219-design/me218/README.md

# me218
Repo for Smart Product Design Lab Alumni content!
