219-design/me218/pcb-ruler/mechanical/README.md

# ME218 PCB Ruler Mechanical Resources

Explore our demo designs in [Onshape](https://cad.onshape.com/documents/a66641dbc2e63d92f0bfc751/w/f00ac217e622a64d2a372b85/e/9fa5ab666376091f7bf63026). 

Mechanical Demos

This folder is for 3D printable resources and assembly instructions for add-ons to the PCB ruler.

Looking for a design related to an interdisciplinary project? Check out the [examples folder](https://github.com/219-design/me218/tree/lib/pcb-ruler/firmware/ruler_lib/examples).

---

The PCB ruler is also a great platform for **3D-printed attachments**.  

We’ve designed a **3D-printable clamp** that securely grips the ruler and can be adapted for a variety of uses — such as **tool holders**, **marking tools**, or other creative mechanical add-ons.  

## Demo Photos
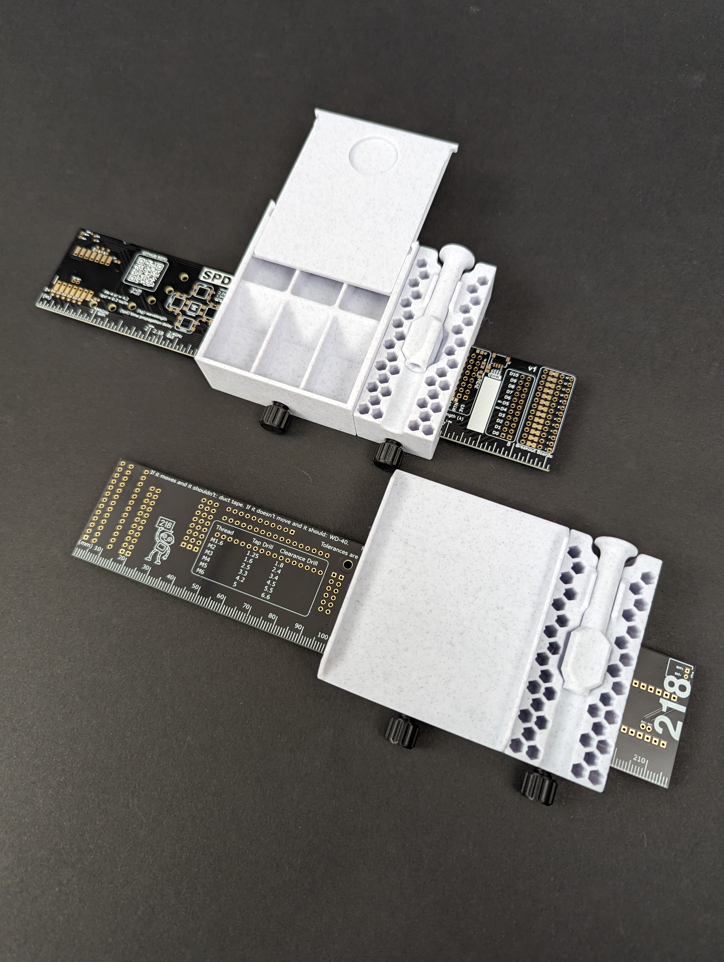
[picture p5: pcb-ruler/mechanical/photos/PXL_20251010_201851201.jpg]
Storage

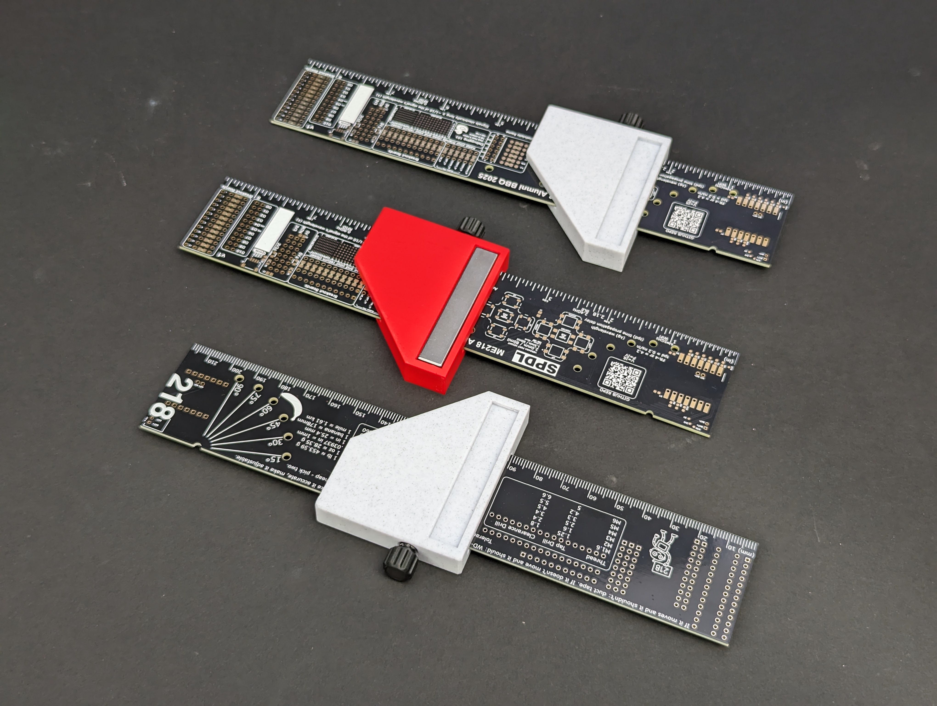
[picture p6: pcb-ruler/mechanical/photos/PXL_20251009_214241313.jpg]
Marking Tool


## CAD Photos
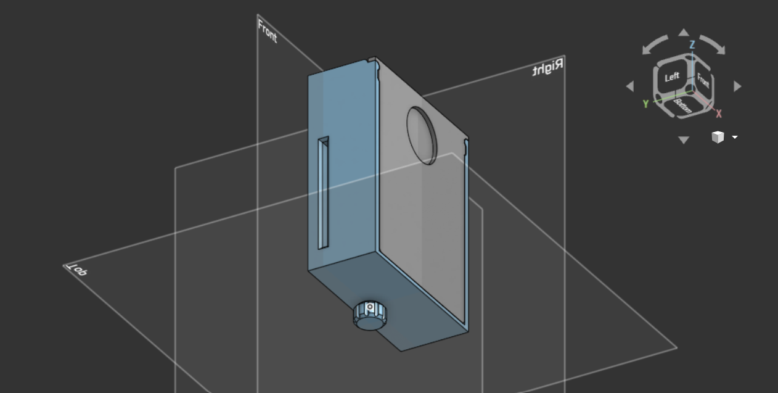
[picture p7: pcb-ruler/mechanical/photos/Screenshot 2025-10-10 151649.png]
CAD Photo 1

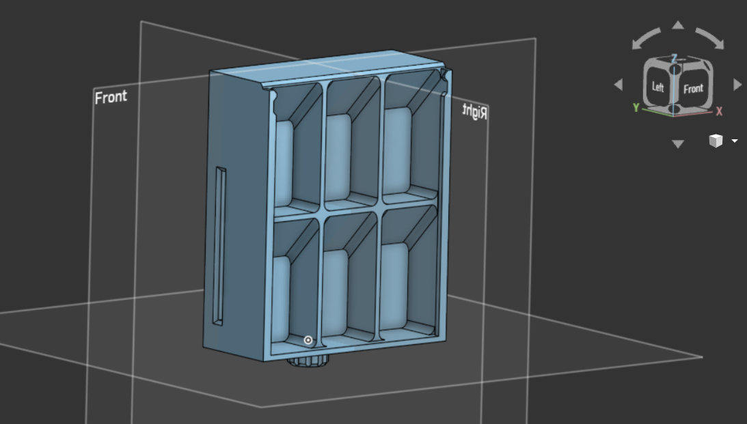
[picture p8: pcb-ruler/mechanical/photos/Screenshot 2025-10-10 151750.png]
CAD Photo 2

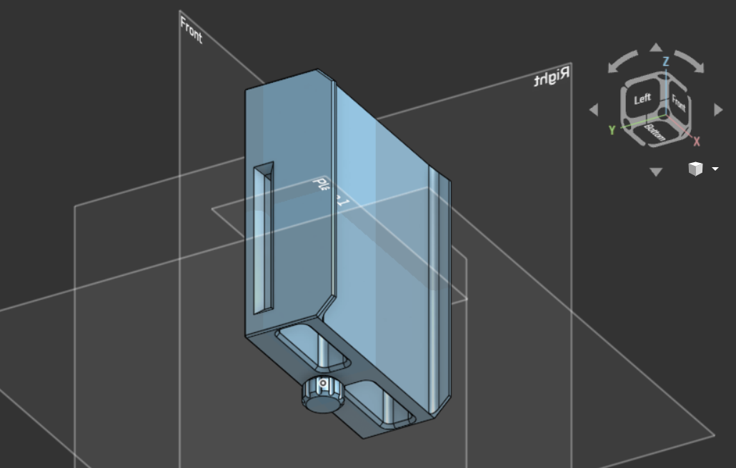
[picture p9: pcb-ruler/mechanical/photos/Screenshot 2025-10-10 151845.png]
CAD Photo 3

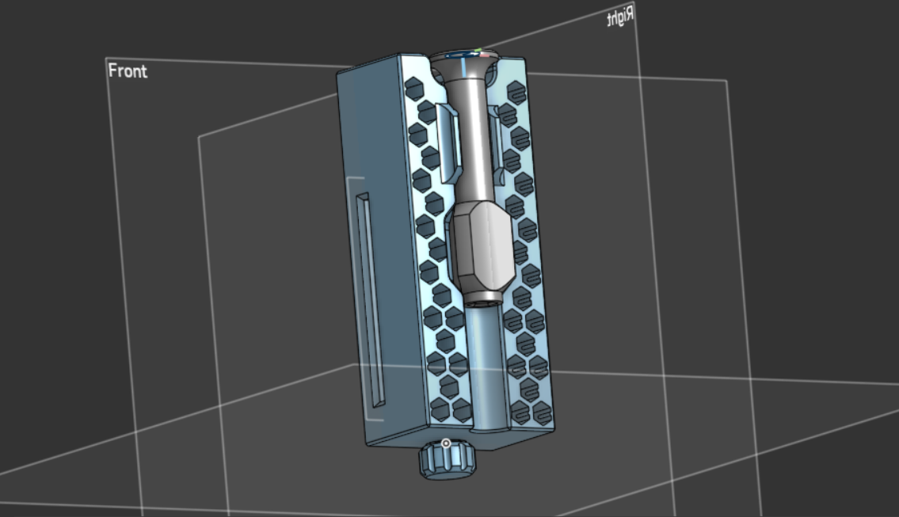
[picture p10: pcb-ruler/mechanical/photos/Screenshot 2025-10-10 152130.png]
CAD Photo 4

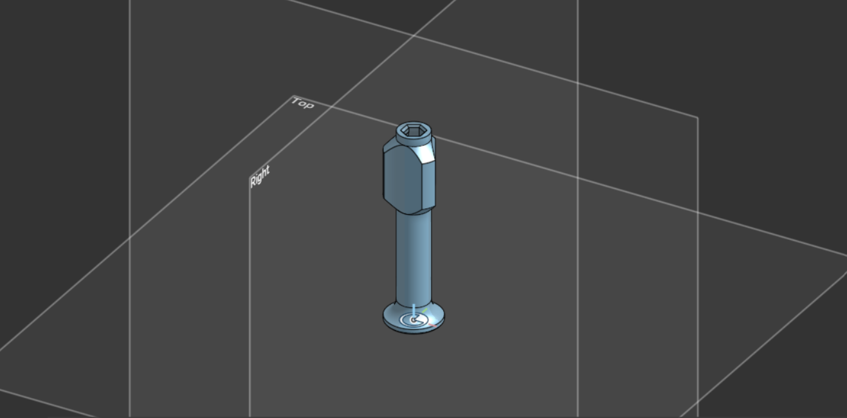
[picture p11: pcb-ruler/mechanical/photos/Screenshot 2025-10-10 152235.png]
CAD Photo 5

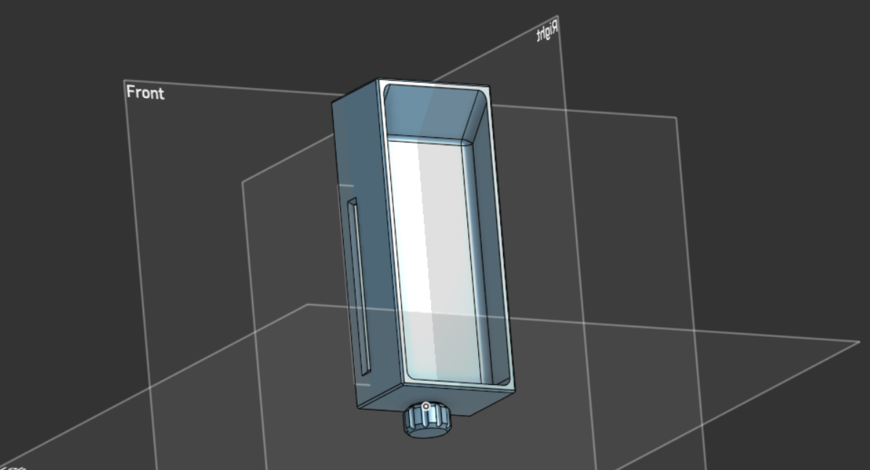
[picture p12: pcb-ruler/mechanical/photos/Screenshot 2025-10-10 152332.png]
CAD Photo 6
