219-design/me218/pcb-ruler/firmware/README.md

# ME218 PCB Ruler Firmware Resources
This folder contains firmware examples for basic component functionality.

## Ruler Lib

The Ruler Lib is small collection of classes for using some of the hardware features of the ruler board. 

### Installing Ruler Lib

Open the Arduino IDE. 

Select: Sketch Menu >> Include Library >> Add .ZIP library...

In the file dialog, find the ruler_lib.zip file

This will install the ruler_lib to use with sketches

### Editing the Ruler Lib

If you'd like to make changes to the lib, you can modify the files in the src folder. Then compress the entire "ruler_lib" directory into a zip file and (re)install the new library from zip as described above.

### Included Examples

All examples in this repository are included in the Arduino IDE when the Ruler Lib is installed. To open an example from the IDE, such as the Simon Game example:

Select: File >> Examples >> ruler_lib >> simon_says

Any dependent libraries are noted with the github repository in the example code.

### Seed XIAO Boards 

Install Seed XIAO Boards the as instructed by:
https://wiki.seeedstudio.com/XIAO_BLE/#getting-started
