219-design/me218/pcb-ruler/firmware/ruler_lib/examples/tof_ruler/README.md

# ME218 PCB Ruler - ToF Ruler

This sketch creates line of sight digital ruler utilizing a time of flight sensor. Distances measured from the sensor will be displayed on the OLED screen. Pressing the button will change units from imperial to metric. Distances greater than 5400mm are outside of the sensors operating range and will not be accurate.

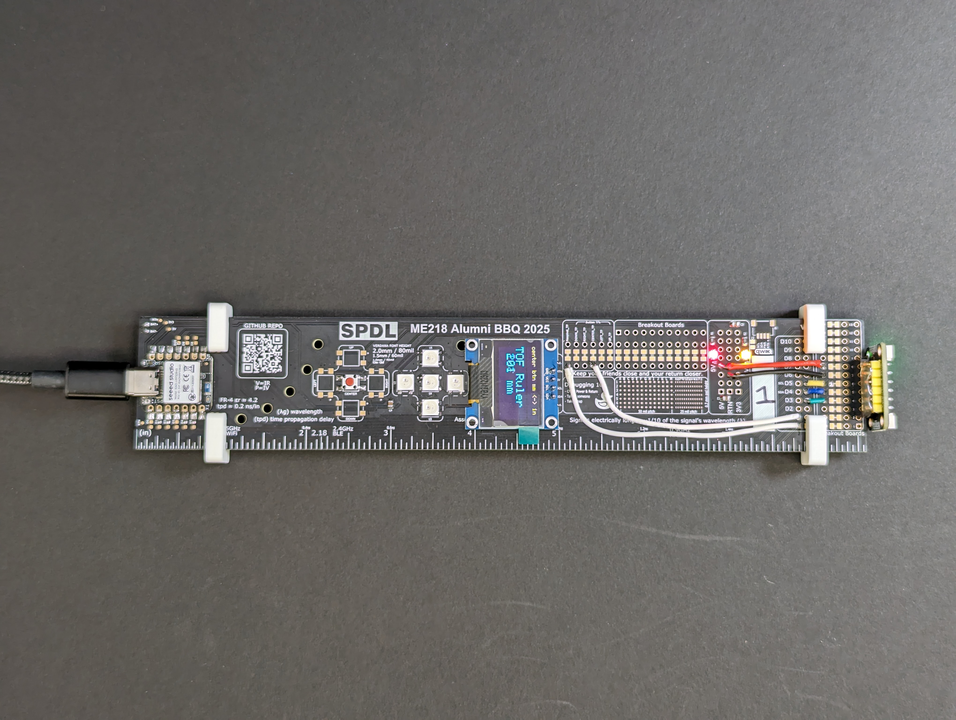
[picture p16: pcb-ruler/firmware/ruler_lib/examples/tof_ruler/photos/PXL_20251009_213353691.jpg]
tof
