219-design/me218/pcb-ruler/electrical/V1/ME218 Ruler v1 PCBA 3D (Bottom view).PDF

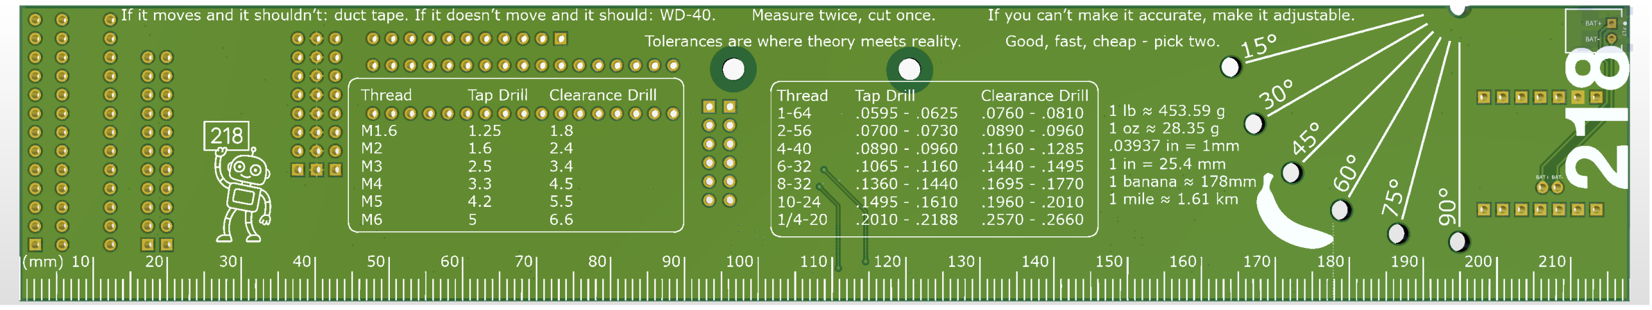
[picture p17: figure]
