219-design/me218/pcb-ruler/electrical/V1/ME218 Ruler v1 PCBA 3D (Top view).PDF

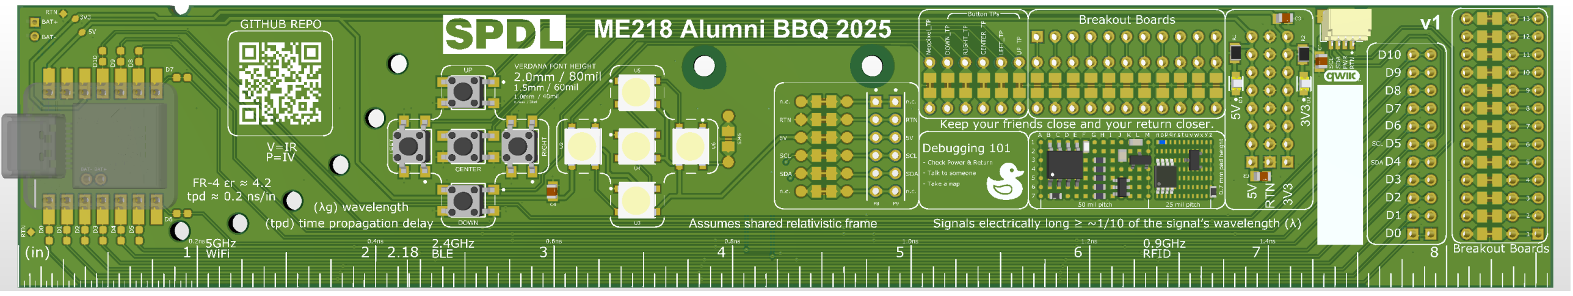
[picture p18: figure]
