219-design/me218/pcb-ruler/firmware/ruler_lib/examples/digital_level/ME218 RULER - - level.png

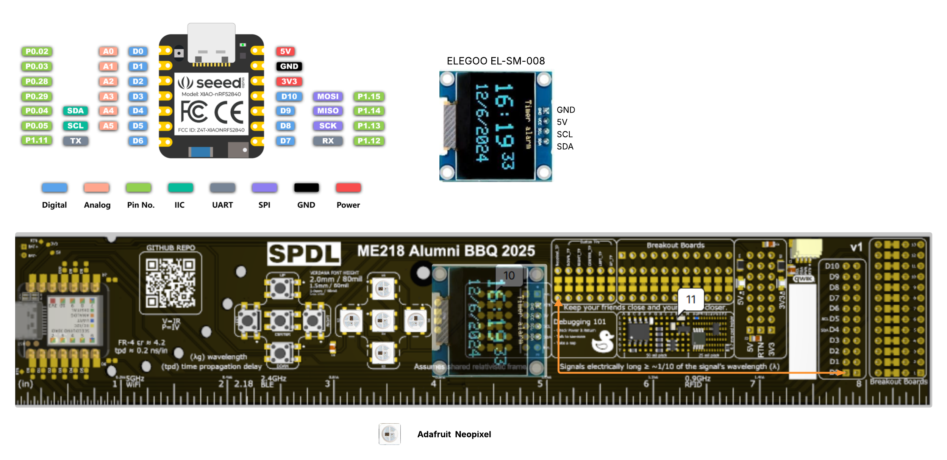
pcb-ruler/firmware/ruler_lib/examples/digital_level/ME218 RULER - - level.png
