219-design/me218/pcb-ruler/firmware/ruler_lib/examples/digital_level/photos/PXL_20251009_213537078.jpg

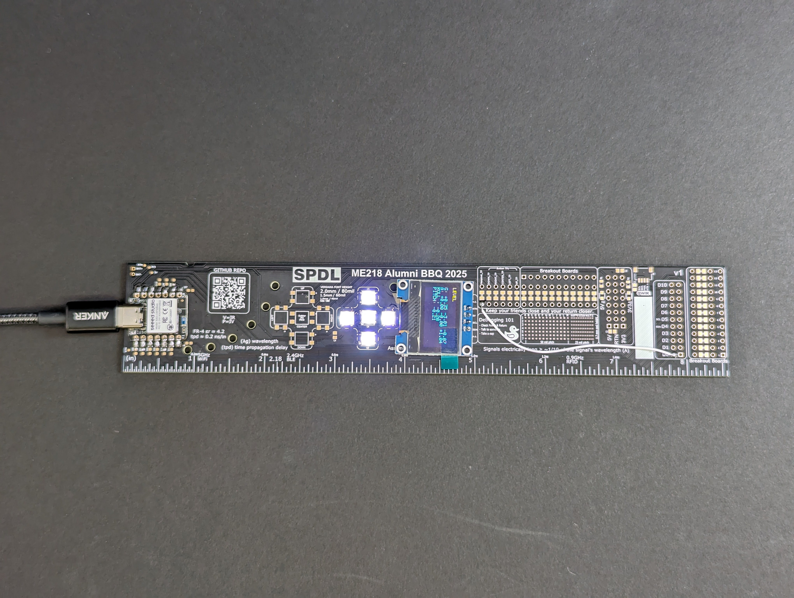
pcb-ruler/firmware/ruler_lib/examples/digital_level/photos/PXL_20251009_213537078.jpg
