219-design/me218/pcb-ruler/firmware/ruler_lib/examples/simon_says/ME218 RULER - - simon.png

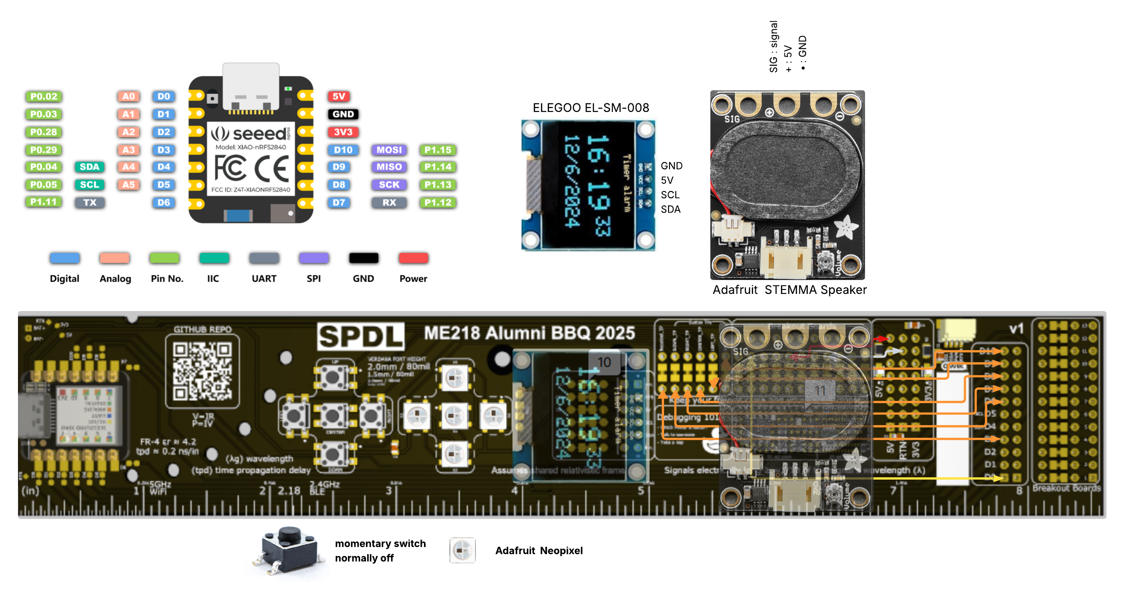
pcb-ruler/firmware/ruler_lib/examples/simon_says/ME218 RULER - - simon.png
