219-design/me218/pcb-ruler/firmware/ruler_lib/examples/simon_says/photos/PXL_20251009_213451061.jpg

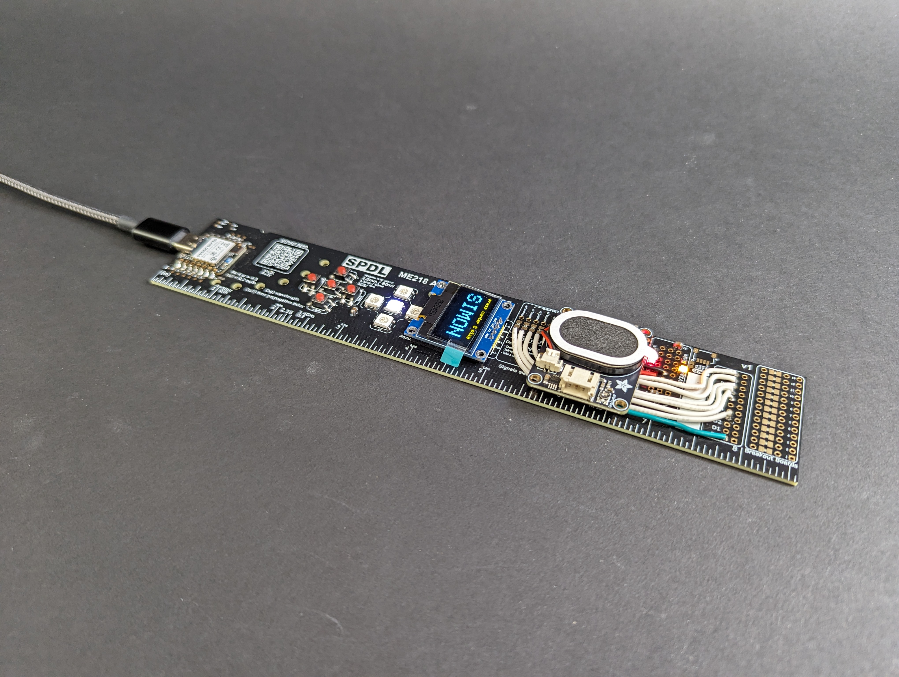
pcb-ruler/firmware/ruler_lib/examples/simon_says/photos/PXL_20251009_213451061.jpg
