219-design/me218/pcb-ruler/firmware/ruler_lib/examples/thermal_camera/ME218 RULER - - thermal cam.png

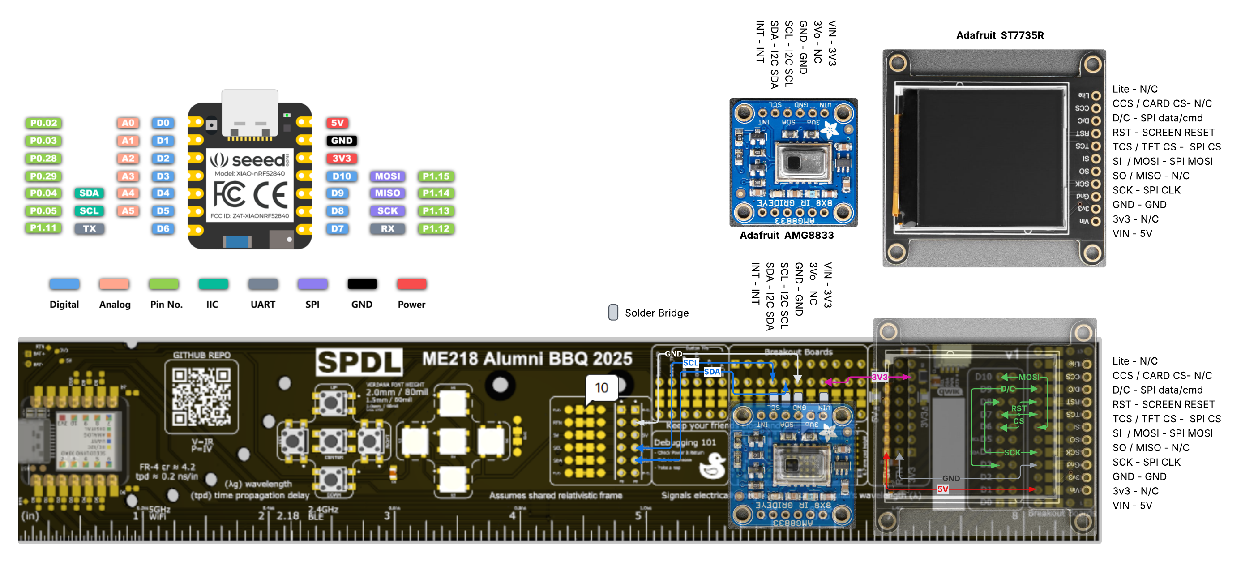
pcb-ruler/firmware/ruler_lib/examples/thermal_camera/ME218 RULER - - thermal cam.png
