219-design/me218/pcb-ruler/firmware/ruler_lib/examples/thermal_camera/photos/PXL_20251009_213652297.jpg

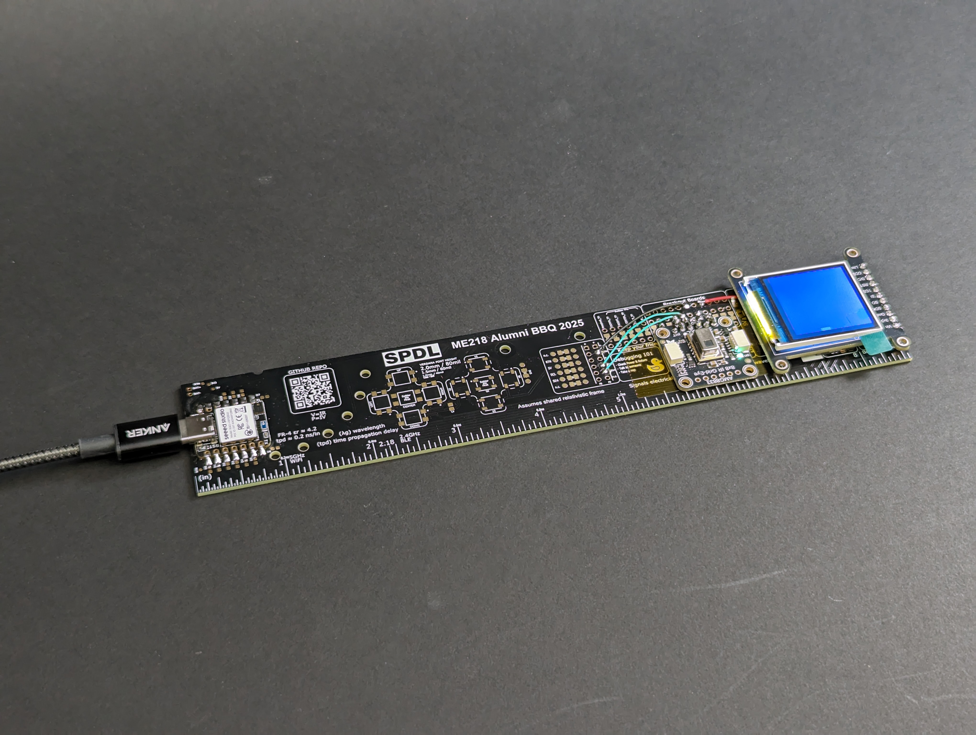
pcb-ruler/firmware/ruler_lib/examples/thermal_camera/photos/PXL_20251009_213652297.jpg
