219-design/me218/pcb-ruler/firmware/ruler_lib/examples/thermal_camera/photos/PXL_20251009_213659883.jpg

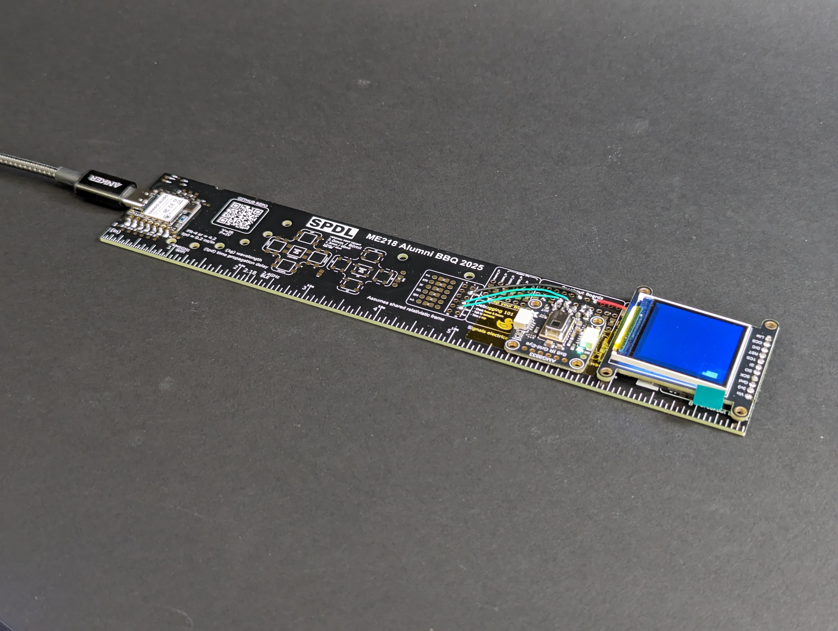
pcb-ruler/firmware/ruler_lib/examples/thermal_camera/photos/PXL_20251009_213659883.jpg
