219-design/me218/pcb-ruler/firmware/ruler_lib/examples/tof_ruler/ME218 RULER - - ToF.png

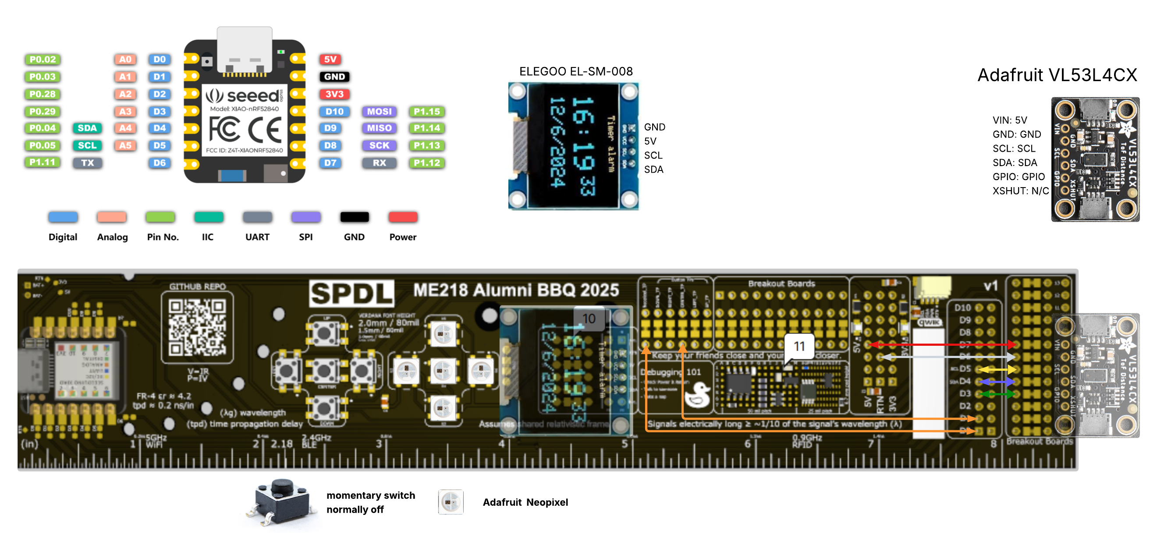
pcb-ruler/firmware/ruler_lib/examples/tof_ruler/ME218 RULER - - ToF.png
