219-design/me218/pcb-ruler/firmware/ruler_lib/examples/tof_ruler/photos/PXL_20251009_213426381.jpg

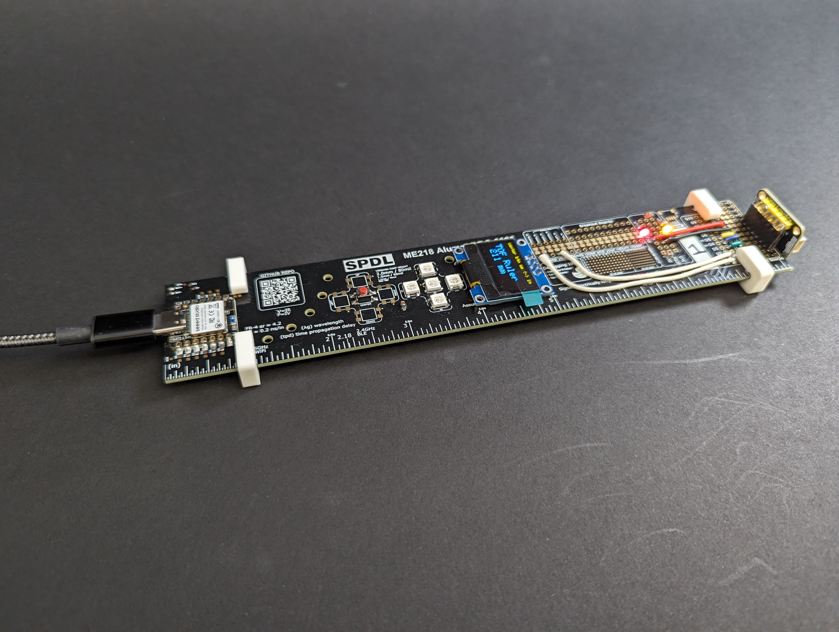
pcb-ruler/firmware/ruler_lib/examples/tof_ruler/photos/PXL_20251009_213426381.jpg
