219-design/me218/pcb-ruler/mechanical/photos/PXL_20251009_214215333.jpg

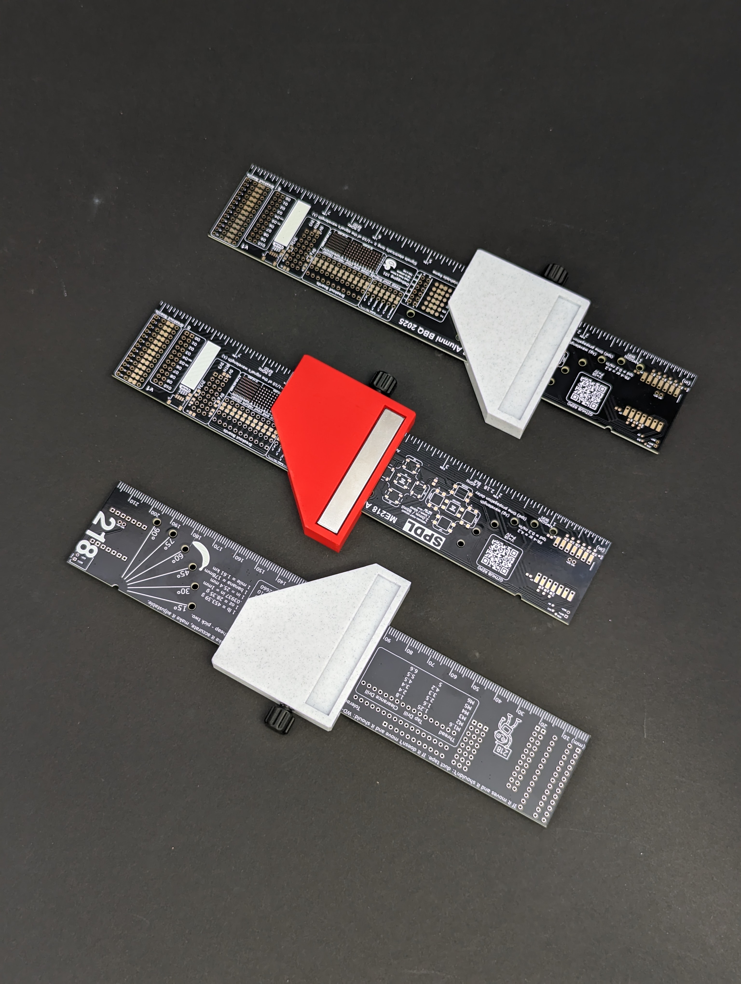
pcb-ruler/mechanical/photos/PXL_20251009_214215333.jpg
