219-design/me218/pcb-ruler/mechanical/photos/PXL_20251010_201904710.jpg

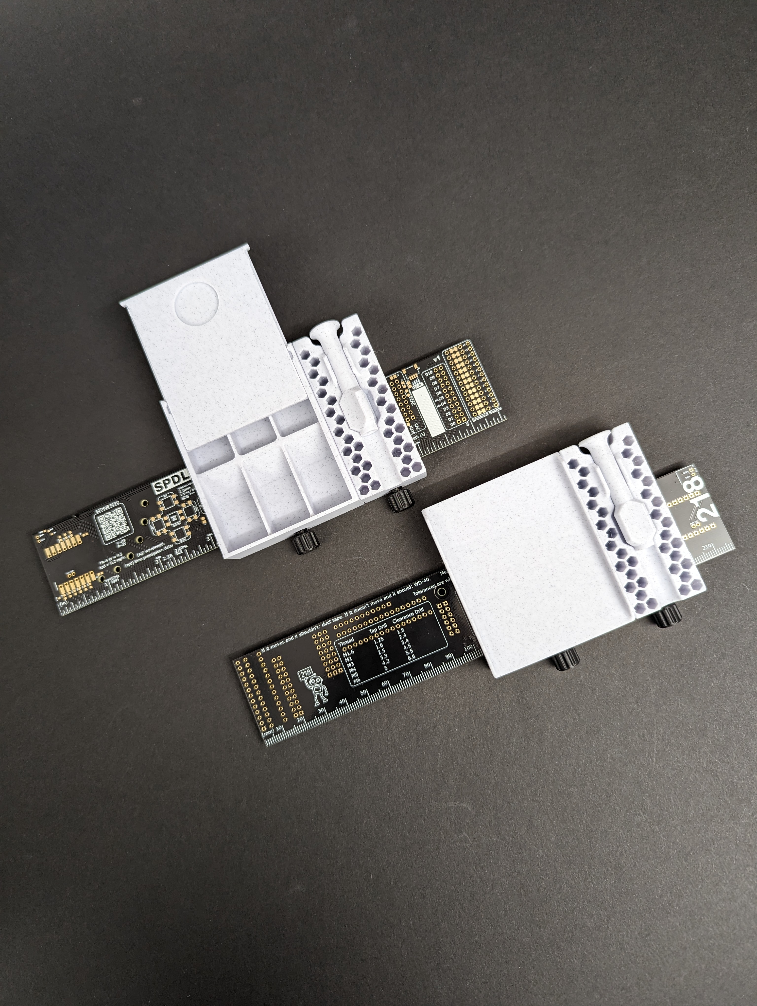
pcb-ruler/mechanical/photos/PXL_20251010_201904710.jpg
