219-design/me218/pcb-ruler/mechanical/photos/PXL_20251010_202214640.MP.jpg

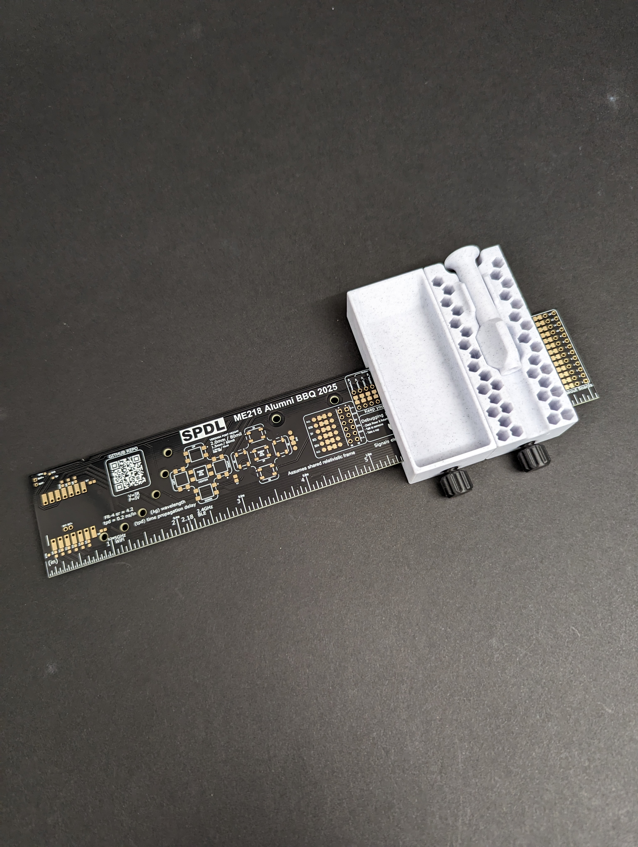
pcb-ruler/mechanical/photos/PXL_20251010_202214640.MP.jpg
