219-design/me218/pcb-ruler/mechanical/photos/PXL_20251010_202243108.MP.jpg

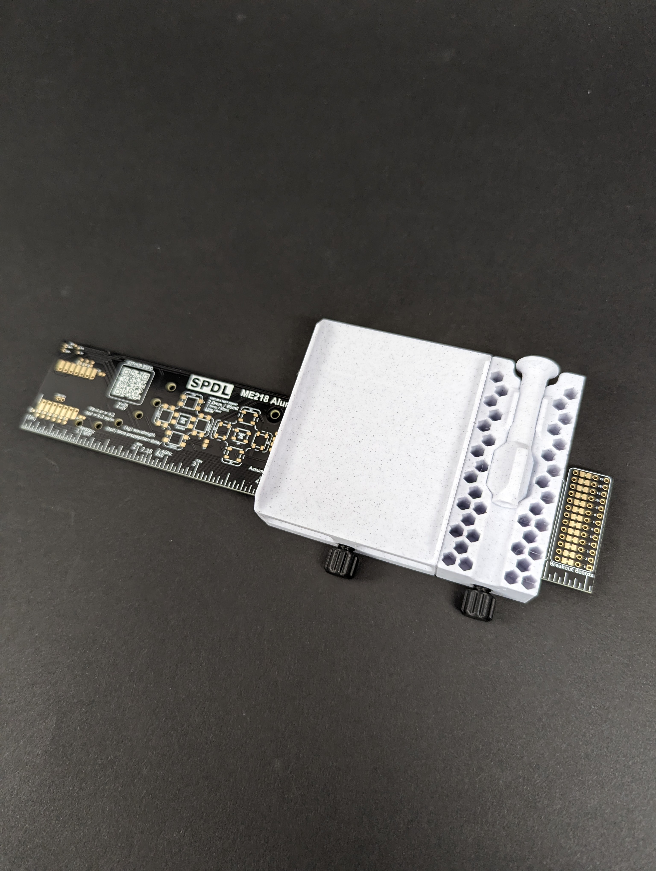
pcb-ruler/mechanical/photos/PXL_20251010_202243108.MP.jpg
