219-design/me218/pcb-ruler/mechanical/photos/PXL_20251010_202251202.jpg

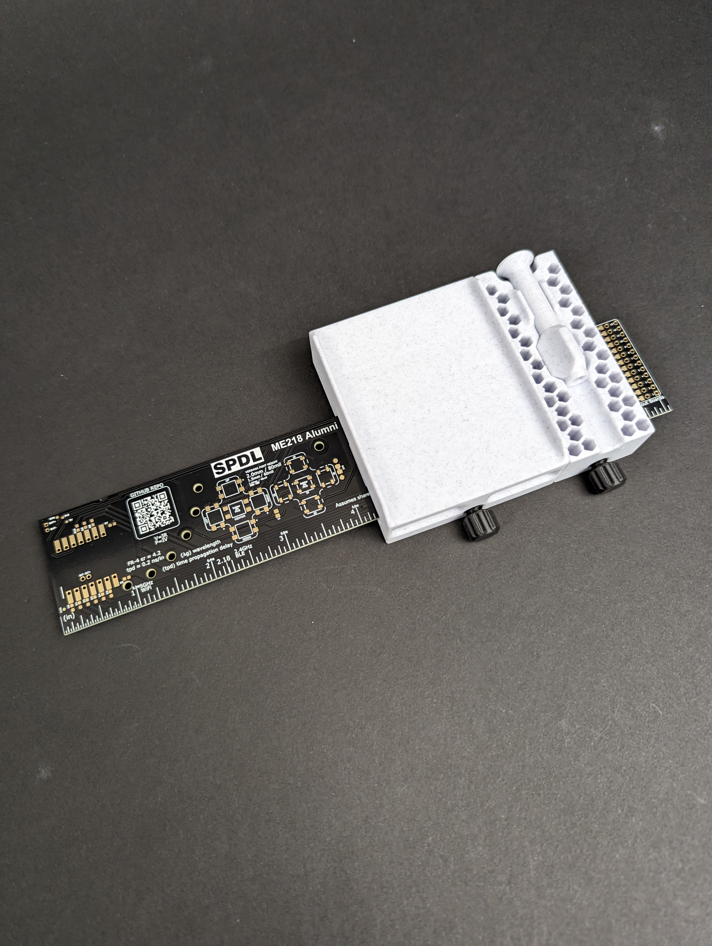
pcb-ruler/mechanical/photos/PXL_20251010_202251202.jpg
