219-design/me218/pcb-ruler/mechanical/photos/PXL_20251010_215758462.jpg

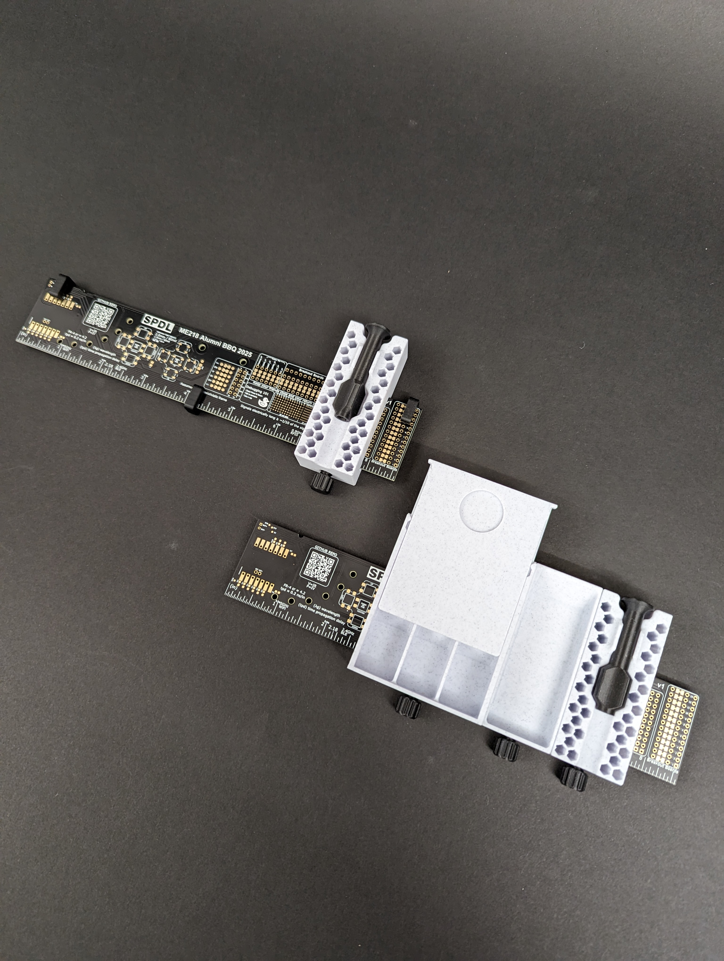
pcb-ruler/mechanical/photos/PXL_20251010_215758462.jpg
