219-design/me218/pcb-ruler/mechanical/photos/PXL_20251010_215806261.jpg

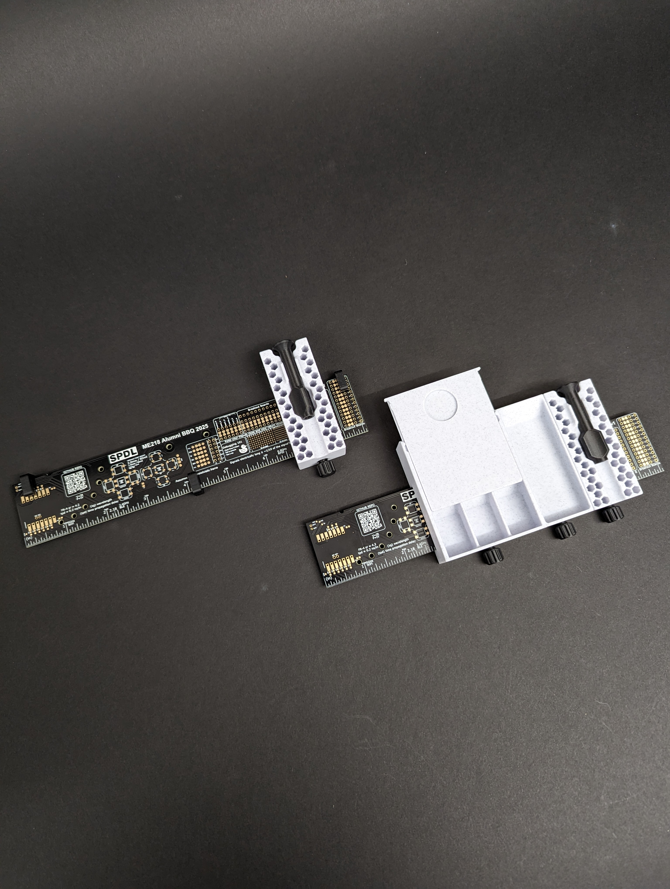
pcb-ruler/mechanical/photos/PXL_20251010_215806261.jpg
