219-design/me218/pcb-ruler/electrical/V1/BOM/README.md

# ME218 PCB Ruler BOM
This folder contains a basic BOM for the items used on most demos.

Interested in a specific project? Check out the demo specific folder.
