219-design/me218/pcb-ruler/firmware/ruler_lib/examples/tof_ruler/ME218 Ruler v1 BOM - ToF.xlsx

 | Bill of Materials
 | Project Name: | ME218 Ruler
 | Report Date: | 9/5/2025 | 17:09
 | Engineer: | 219 Design
 | BOM Revision History
 | Version | Date | Description
 | v1 | 9/5/2025 | Initial release
# | Designator | Description | Manufacturer 1 | Manufacturer Part Number 1 | Supplier 1 | Supplier Part Number 1 | Fitted | Footprint | Quantity
1 | C1-C4 | Multilayer Ceramic Capacitor, 1 uF, 50 V, ± 10%, X7R, 0805 [2012 Metric] | Murata | GCM21BR71H105KA03K | DigiKey | 490-13310-1-ND | Fitted | FP-GRM21B-0_15-IPC_B | 4
2 | CENTER | Keypad Switch, 1 Switches, SPST, Momentary-tactile, 0.05A, 12VDC, 2.45N, Solder Terminal, Surface Mount-straight | E-Switch | TL3305AF260QG | DigiKey | EG5353CT-ND | Fitted | FP-TL3305AF260QG-MFG | 1
2 | DOWN, LEFT, RIGHT, UP | Keypad Switch, 1 Switches, SPST, Momentary-tactile, 0.05A, 12VDC, 2.45N, Solder Terminal, Surface Mount-straight | E-Switch | TL3305AF260QG | DigiKey | EG5353CT-ND | Not Fitted | FP-TL3305AF260QG-MFG | 0
4 | D1 | 0805 Single Color LED, Super Red, Colorless Diffused, 1.3mm | Osram Opto | LS R976-NR-1 | Mouser | 720-LSR976-NR-1 | Fitted | FP-LS_R976-MFG | 1
5 | D2 | 0805 Single Color LED, Yellow, Colorless Diffused, 1.3mm | Osram | LY R976-PS-36 | Mouser | 720-LYR976-PS-36 | Fitted | FP-LS_R976-MFG | 1
6 | J1 | QWIIC JST CONNECTOR - SMD 4-PIN | SparkFun | 14417 | DigiKey | 1568-14417-ND | Not Fitted | SPARKFUN_PRT-14417 | 0
7 | P17 | Header for PCB; pitch 2.00mm; 2-contacts; THT; male; side entry; 100V/2A | JST | S2B-PH-K-S(LF)(SN) | Future Electronics | 7754757 | Not Fitted | JST-S2B-PH-K-S_V | 0
8 | R1 | SMD Chip Resistor, 300 Ohm, ± 1%, 125 mW, 0805 [2012 Metric], Thin Film, General Purpose | Yageo Group | RT0805FRE07300RL | DigiKey | 13-RT0805FRE07300RLCT-ND | Fitted | RESC2013X60X35NL10T20 | 1
9 | R2 | SMD Chip Resistor, 130 Ohm, ± 1%, 125 mW, 0805 [2012 Metric], Thick Film, Automotive | Vishay | CRCW0805130RFKEA | DigiKey | 541-130CCT-ND | Fitted | RESC2013X60X35NL10T20 | 1
10 | U1 | Seeed studio XIAO series dev boards | Seeed Studio | XIAO nRF52840 Sense | DigiKey | 1597-102010469-ND | Fitted | Seeeduino XIAO-Footprint-Both | 1
11 | U2-U6 | NeoPixel 5050 RGB LED with Integrated Driver Chip - 10 Pack | Adafruit Industries 1655 | Adafruit Industries | 1655 | DigiKey | 1528-1104-ND | Fitted | ADA-RGB-1655_V | 5
12 | P8 | Screen | ELEGOO | EL-SM-008 | Amazon | EL-SM-008 | Fitted | HDR 06 POS 100mil 2.54mm | 1
13 | NA | ToF Module | Adafruit | 5425 | Adafruit | 5425 | Fitted | NA | 1
14 | NA | Female Header, 6pos | Sullins Connector Solutions | PPPC061LFBN-RC | DigiKey | PPPC061LFBN-RC | Fitted | NA | 1
15 | NA | Male RA Header, 6pos | Adam Tech | PH1RB-06-UA | DigiKey | 2057-PH1RB-06-UA-ND | Fitted | NA | 1
16 | NA | Jumper wire | Sparkfun | 11367 | DigiKey | 1568-11367-ND | Fitted | NA | 1
 |  |  |  |  |  |  |  |  | 20
Notes
