219-design/me218/pcb-ruler/electrical/V1/ME218 Ruler v1 Assembly Drawing.PDF

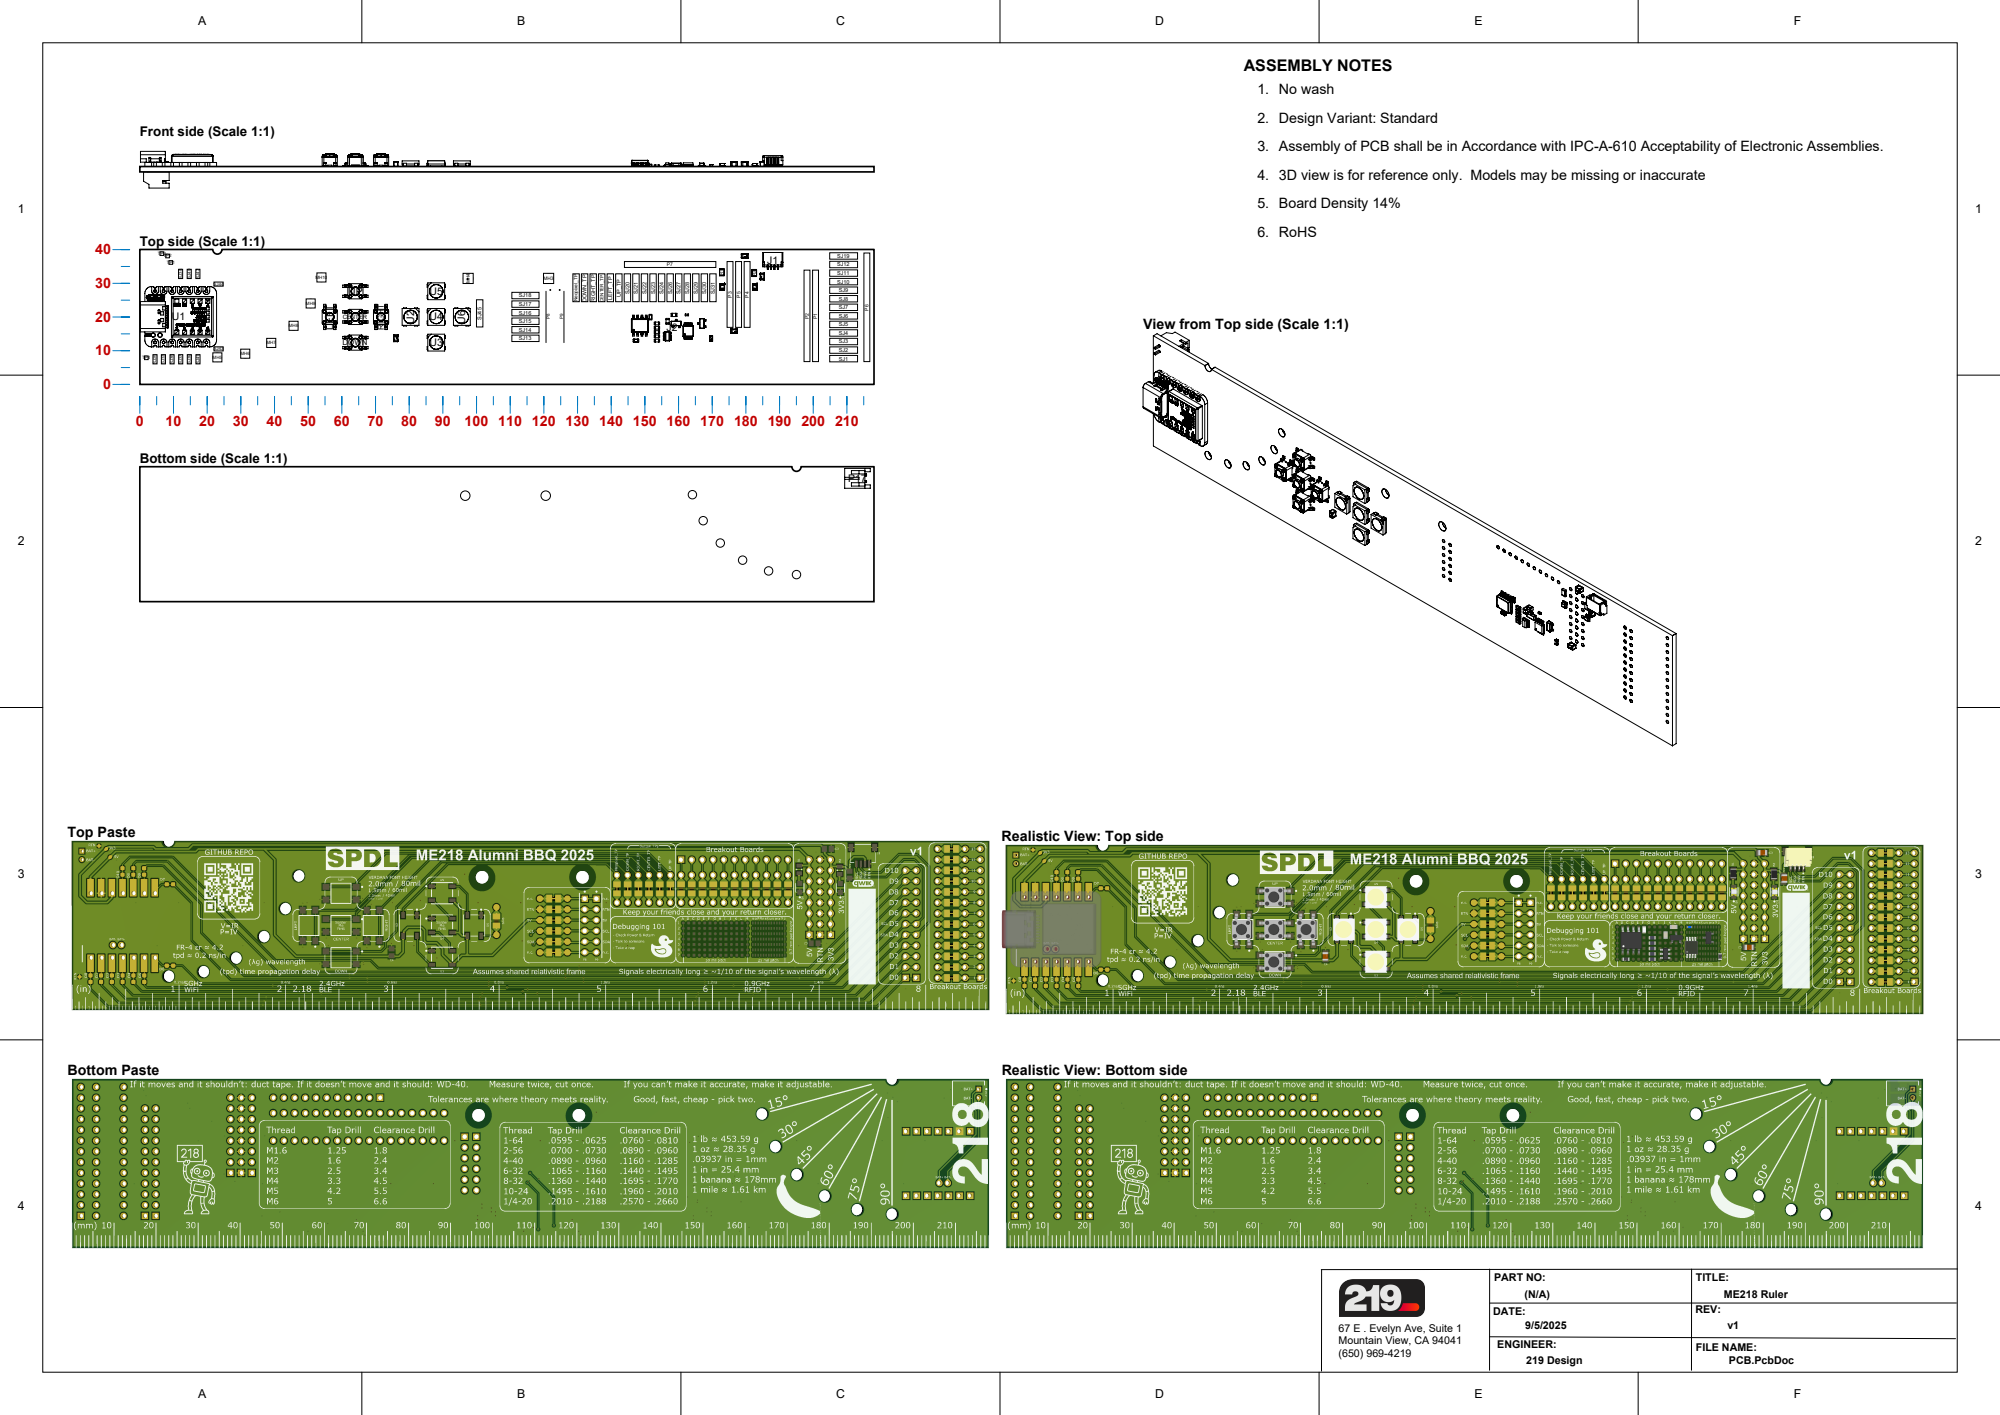
[picture p56: page 1]

ASSEMBLY NOTES
1. No wash
2. Design Variant: Standard
3. Assembly of PCB shall be in Accordance with IPC-A-610 Acceptability of Electronic Assemblies.
4. 3D view is for reference only. Models may be missing or inaccurate
5. Board Density 14%
6. RoHS

View from Top side (Scale 1:1)

Realistic View: Bottom side
