219-design/me218/pcb-ruler/electrical/V1/ME218 Ruler v1 Fabrication Drawing.PDF

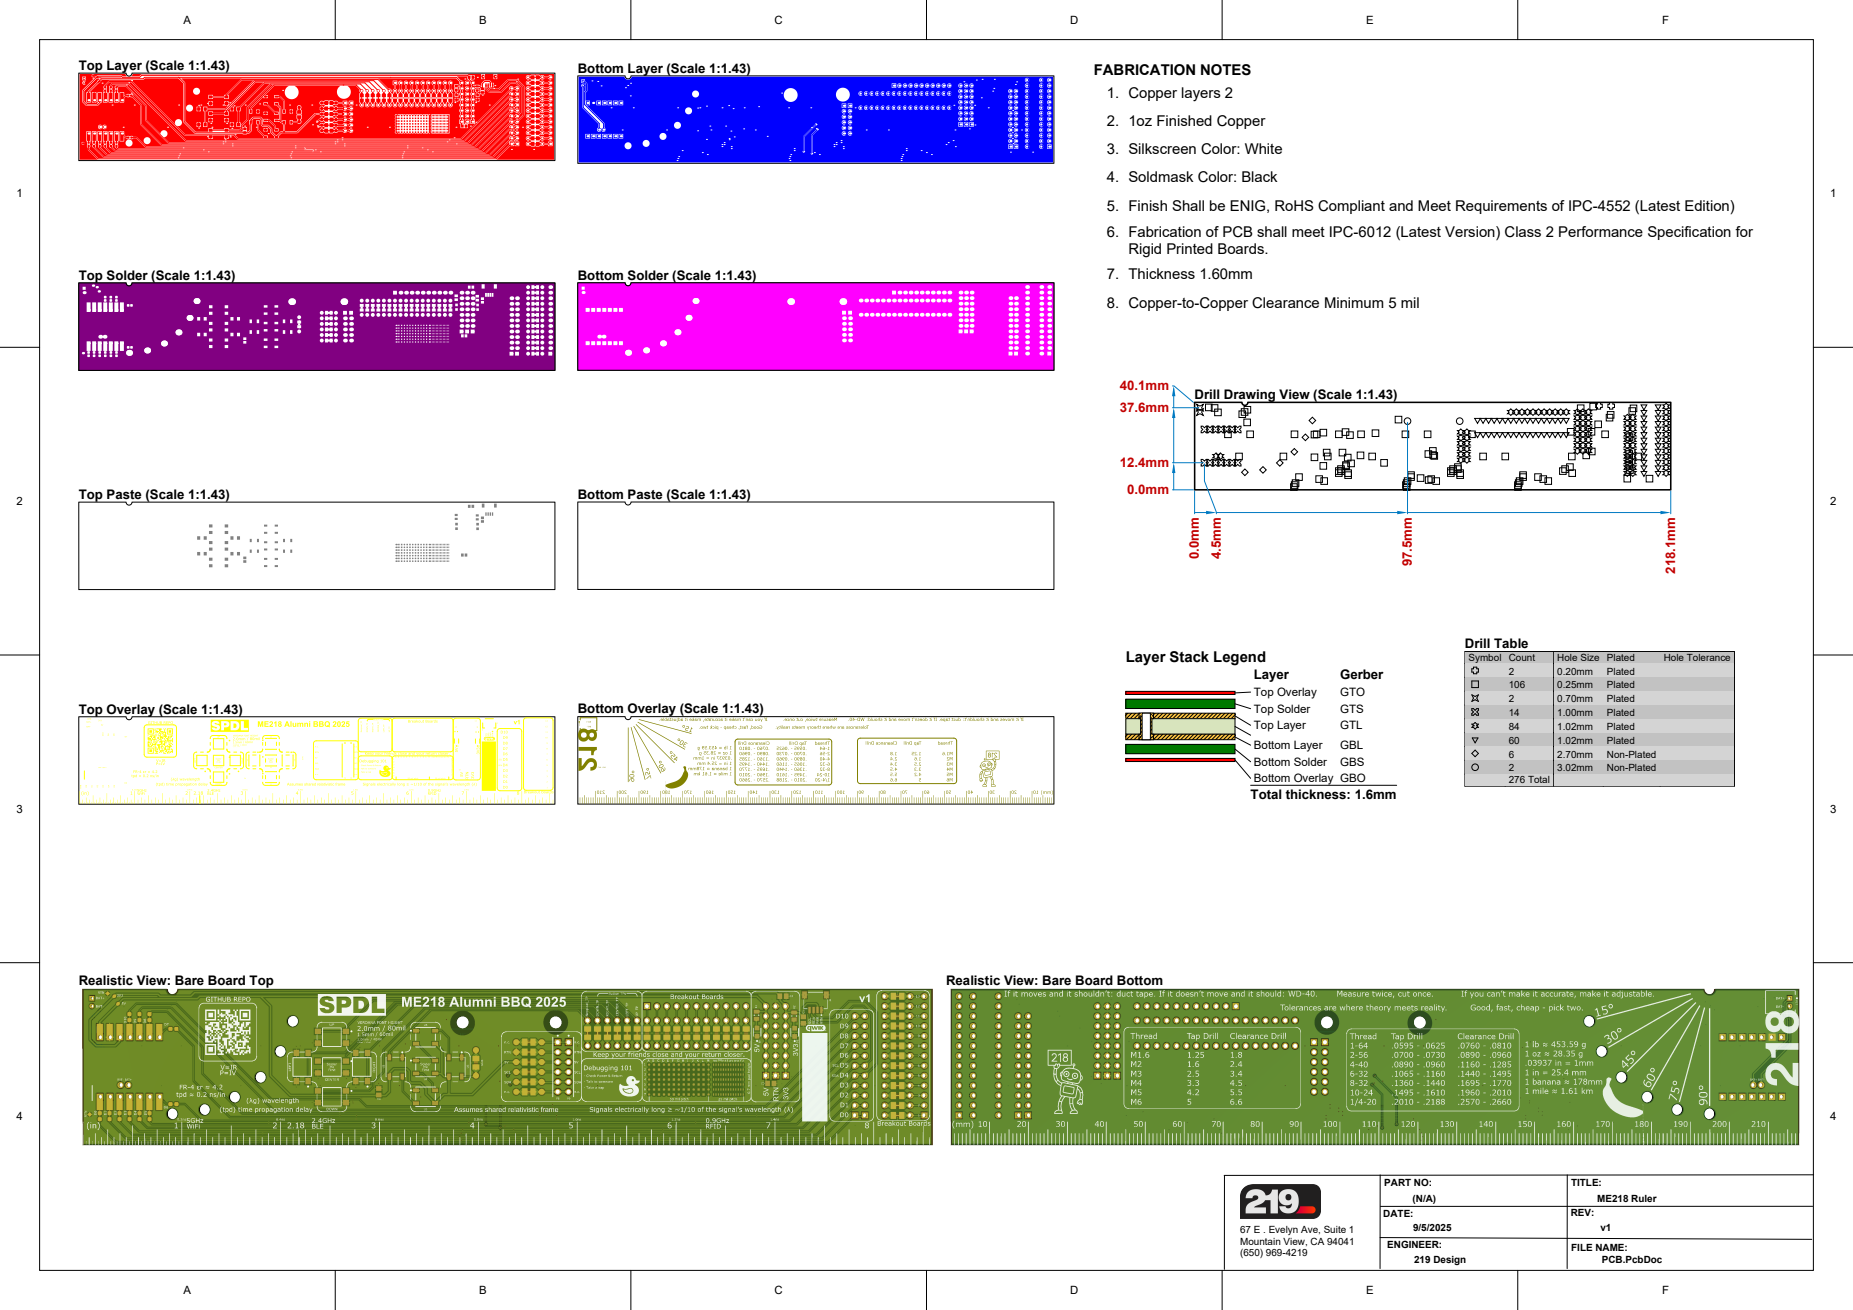
[picture p57: page 1]

FABRICATION NOTES
1. Copper layers 2
2. 1oz Finished Copper
3. Silkscreen Color: White
4. Soldmask Color: Black
5. Finish Shall be ENIG, RoHS Compliant and Meet Requirements of IPC-4552 (Latest Edition)
Fabrication of PCB shall meet IPC-6012 (Latest Version) Class 2 Performance Specification for
Rigid Printed Boards.
7. Thickness 1.60mm
8. Copper-to-Copper Clearance Minimum 5 mil

Drill Drawing View (Scale 1:1.43)
