219-design/me218/pcb-ruler/electrical/V1/ME218 Ruler v1 Schematic.PDF

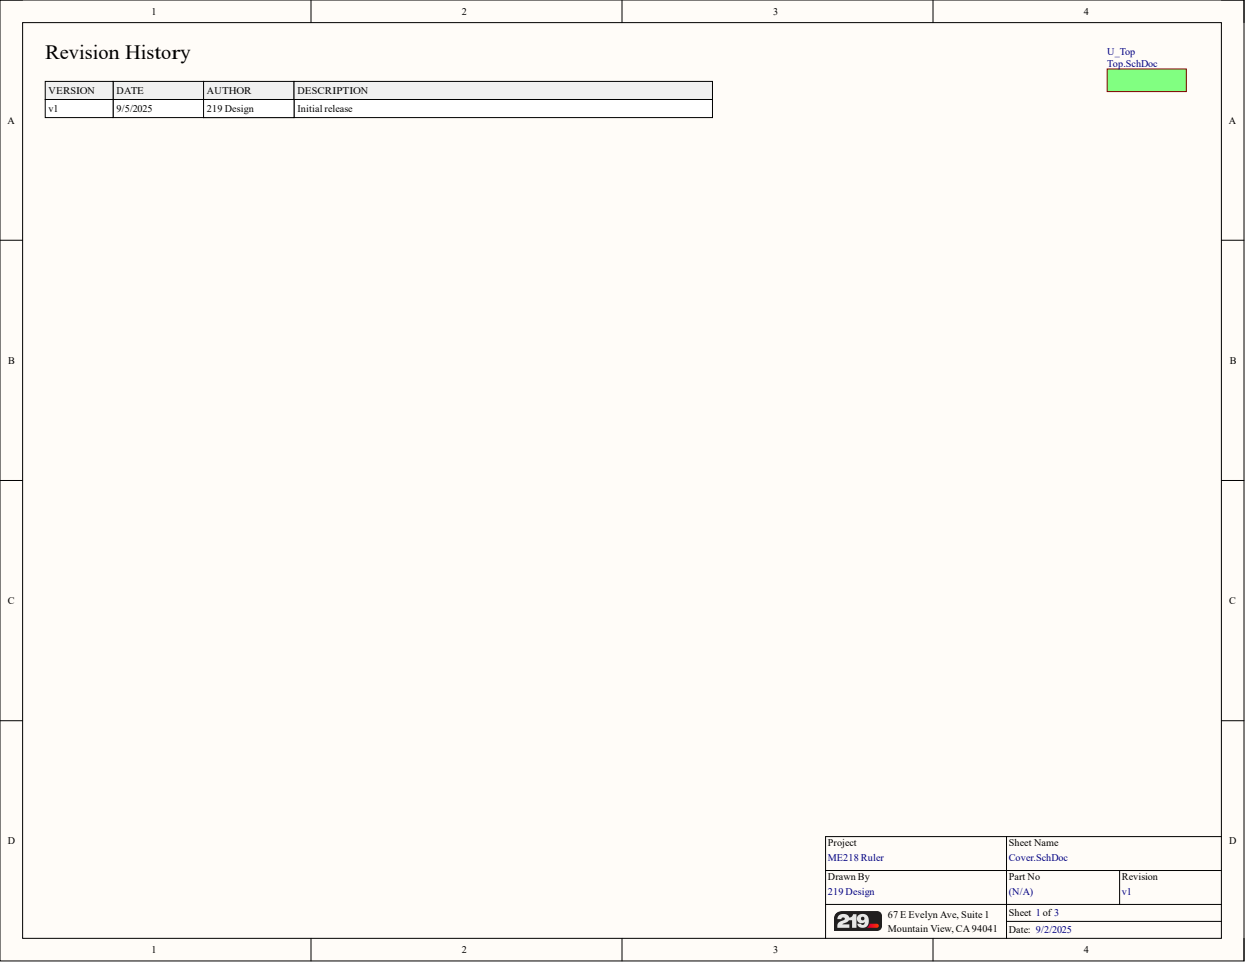
[picture p58: page 1]

VERSION | DATE | AUTHOR | DESCRIPTION
v1 | 9/5/2025 | 219 Design | Initial release

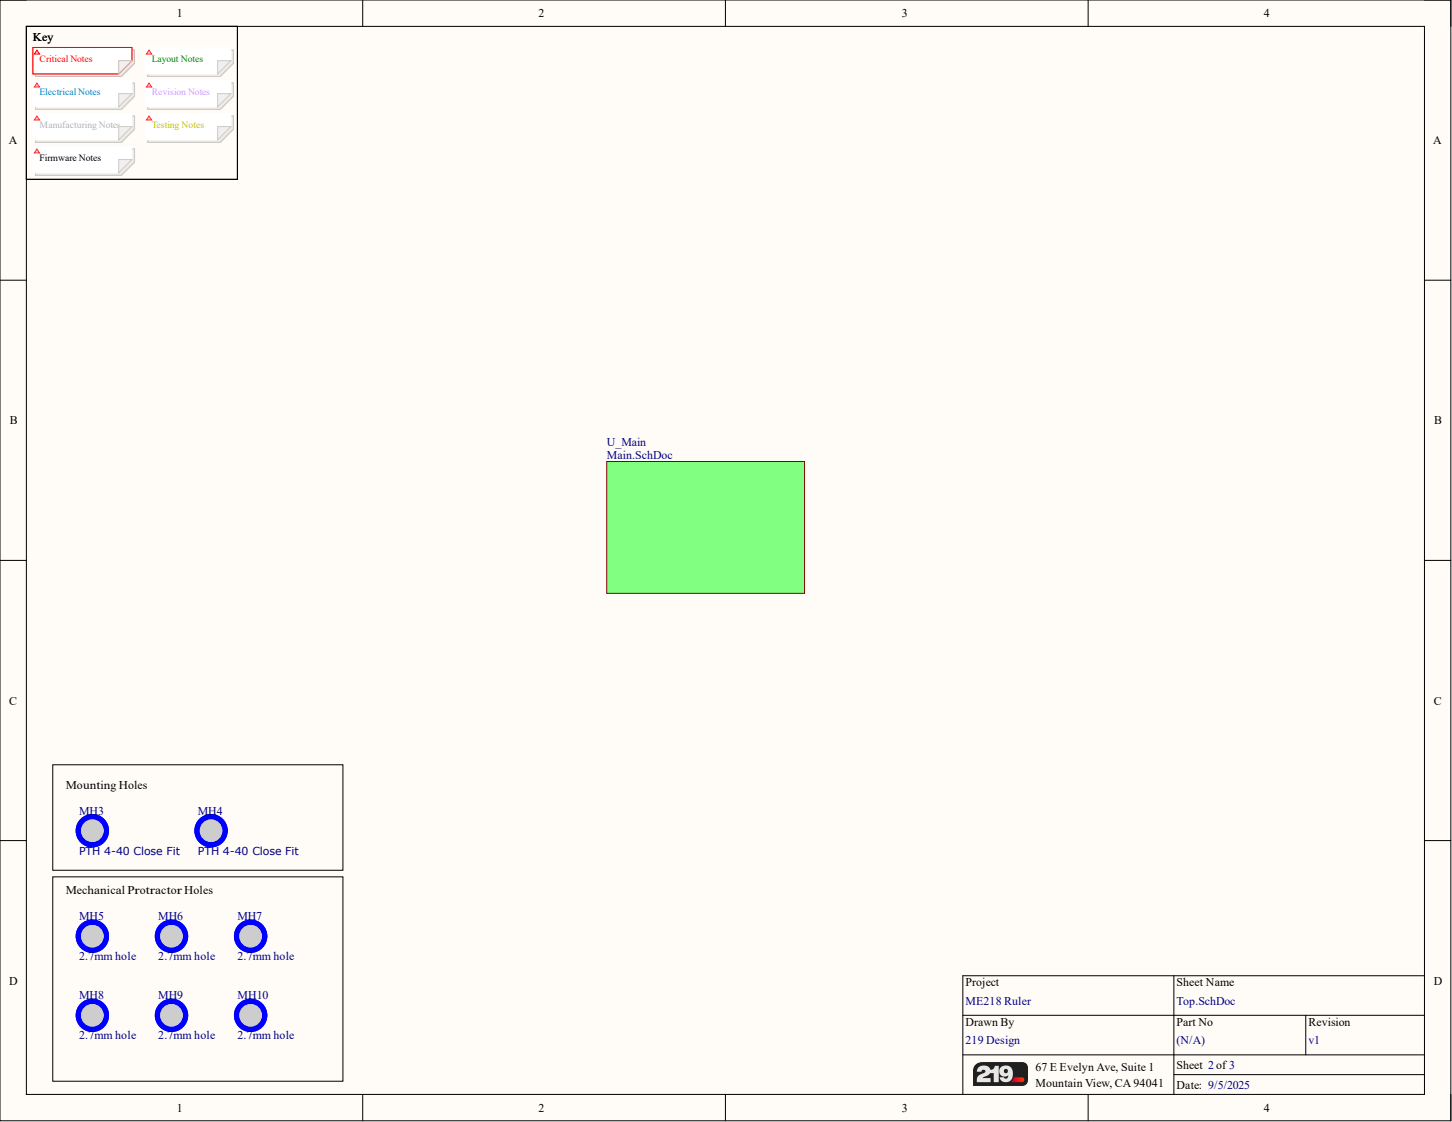
[picture p59: page 2]

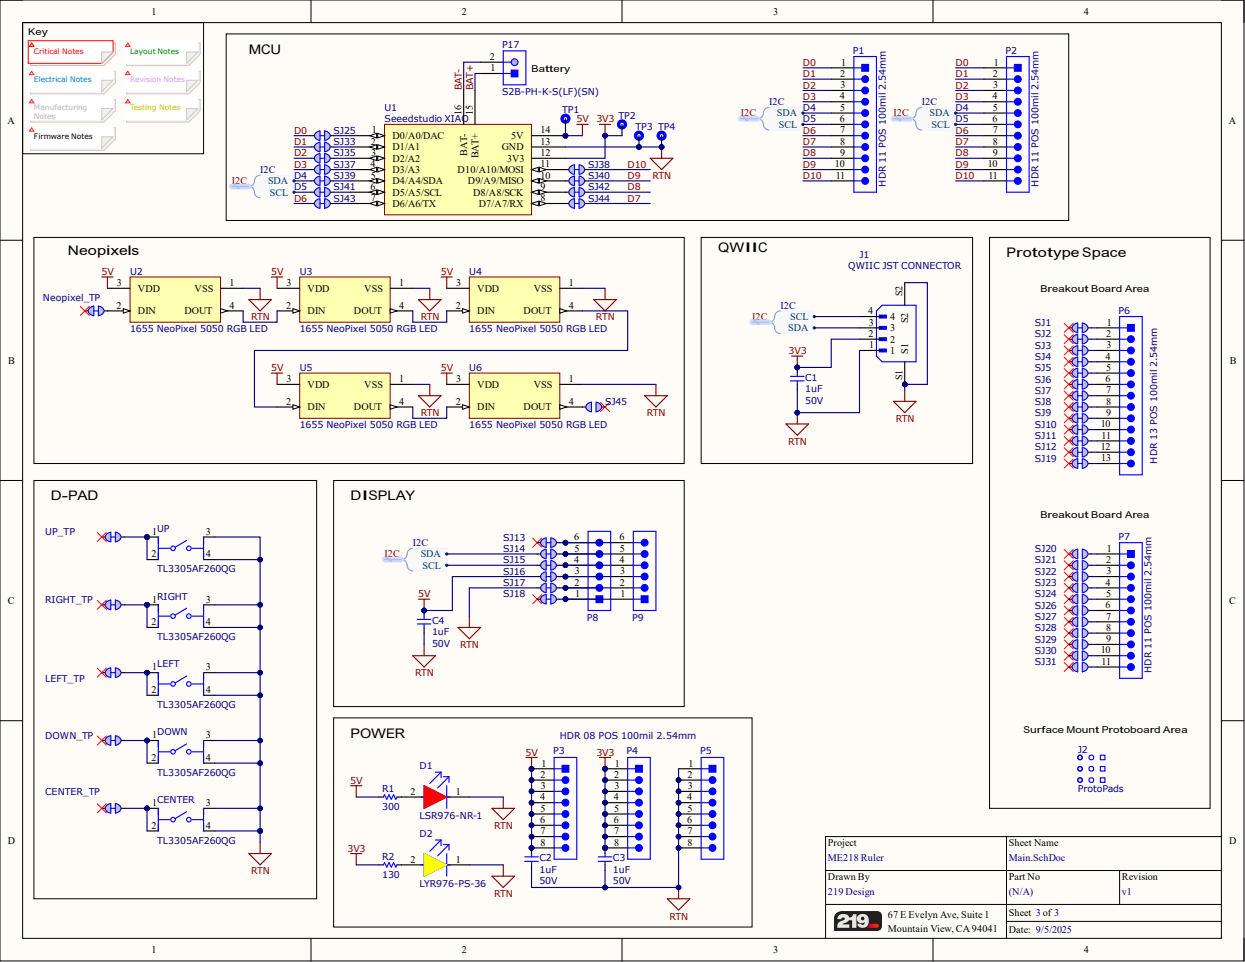
[picture p60: page 3]

S2B-PH-K-S(LF)(SN) BAT+

Surface Mount Protoboard Area
