219-design/me218/(list of files, drawings)

Other design files:
pcb-ruler/electrical/V1/SRC/Cover.SchDoc
pcb-ruler/electrical/V1/SRC/Main.SchDoc
pcb-ruler/electrical/V1/SRC/ME218 PcbRuler.PrjPcb
pcb-ruler/electrical/V1/SRC/PCB.PcbDoc
pcb-ruler/electrical/V1/SRC/Top.SchDoc
