219-design/me218/pcb-ruler/firmware/ruler_lib/src/ruler.h

#ifndef RULER_H_
#define RULER_H_

//neopixels
#define UP_PIXEL_IDX 3
#define DOWN_PIXEL_IDX 1
#define LEFT_PIXEL_IDX 0
#define RIGHT_PIXEL_IDX 4
#define CENTER_PIXEL_IDX 2

#define NUM_PIXELS (5)

//buttons
#define NUM_BTNS (5)

#define BTN_ASSERT_LEVEL 0
#define BTN_DEASSERT_LEVEL 1

#define INVALID_PIN (-1)

#endif //RULER_H_
