219-design/me218/(commit log)

2025-09-25 WIP: initial game mode working with buttons and leds
2025-09-25 better debug msgs; consolidated code for setting pixels by button index
2025-09-25 added missing center_button_mask define; removed animation for successful round completion and updated max rounds
    [simon_says.ino]
2025-09-25 refactored buttons, pixels, and game model logic into individual modules
2025-09-25 moved simon says demo to correct folder
    [ruler.h, simon.cpp, simon.h, simon_says.ino]
2025-09-29 converted button/pixels modules to c++ classes
2025-09-30 adding tof sensor demo
    (cherry picked from commit 018448e45837b95d53c8d5f49984c9d5c4cee1f7)
2025-10-06 - fixed simon example - added correct sounds to simon example - fixed lib source files - new lib zip
    [RulerButtons.cpp, simon_says.ino]
2025-10-08 added thermal camera example
    (cherry picked from commit 55f0a1b0f50747816c1808f10b886ec9d4578acd)
2025-10-09 added wiring diagram images for examples
2025-10-09 add demo boms
    [ME218 Ruler v1 BOM - Digital Level.xlsx, ME218 Ruler v1 BOM - Simon.xlsx, ME218 Ruler v1 BOM - Thermal Camera.xlsx, ME218 Ruler v1 BOM - ToF.xlsx]
2025-10-10 add electrical design files to repo for V1 (#2)
    [Cover.SchDoc, ME218 PcbRuler.PrjPcb, ME218 Ruler v1 BOM.xlsx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]
2025-10-10 updated brightness of leds on simon example
2025-10-10 updated comments in thermal camera sketch
2025-10-10 updating pcb-ruler firmware README
2025-10-10 add mechanical cad photos
